andyshinn/yamb/components/PJ_044A/PJ-044A.step

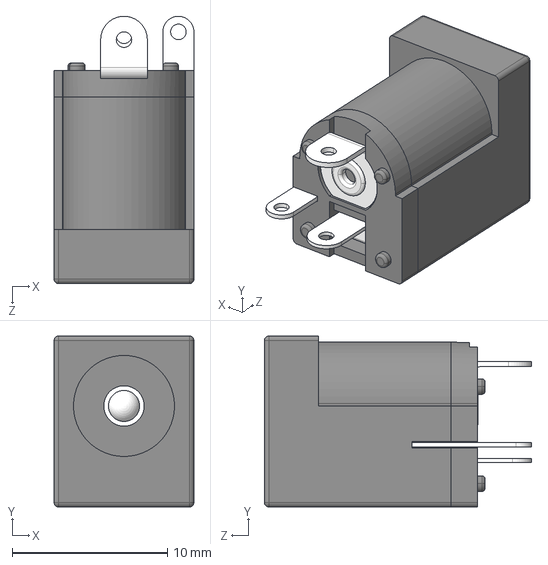
[picture p2: CAD file, 2025-06-29]
components/PJ_044A/PJ-044A.step
9.00 x 11.0 x 17.2 mm
