andyshinn/yamb/components/UJ20-C-V-C-3-SMT-TR.STEP

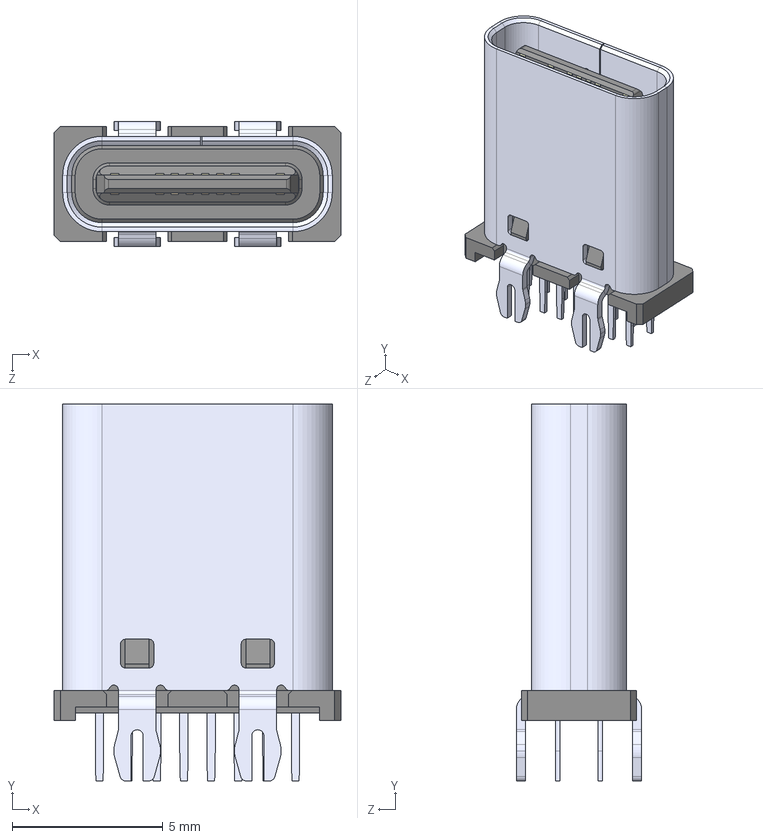
[picture p3: CAD file, 2025-07-02]
components/UJ20-C-V-C-3-SMT-TR.STEP
9.50 x 12.5 x 4.16 mm
