andyshinn/yamb/drawings/PCB - Outline.dxf

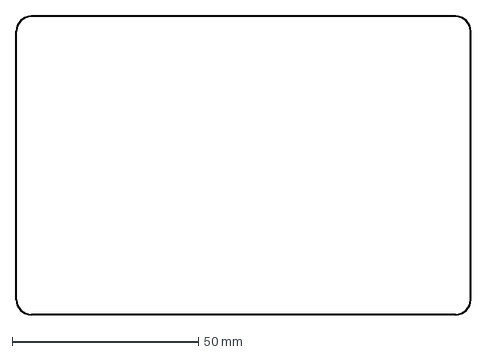
[picture p4: CAD file, 2025-06-27]
drawings/PCB - Outline.dxf
122.0 x 80.0 mm
