andyshinn/yamb/components/RAK4630.step

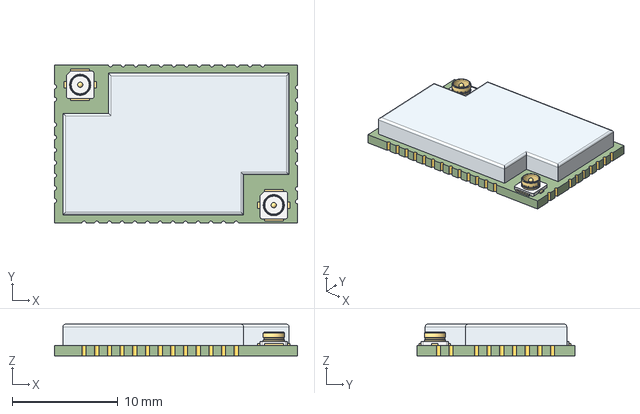
[picture p5: CAD file, 2025-06-29]
components/RAK4630.step
23.0 x 15.0 x 3.00 mm
734120110wbm000_01 x 2
PCB
