andyshinn/yamb/components/SVR.step

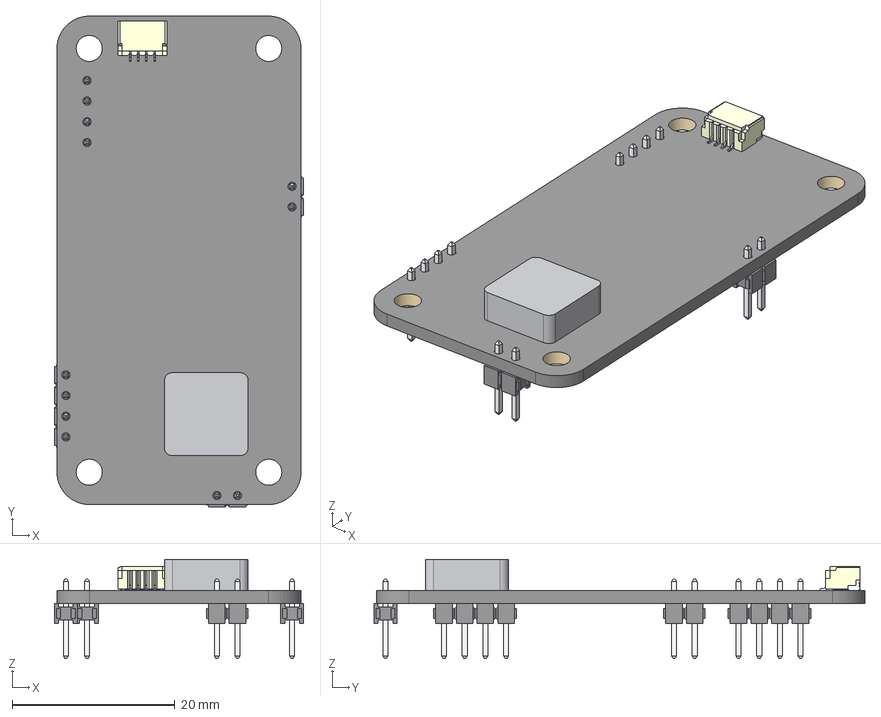
[picture p6: CAD file, 2025-06-29]
components/SVR.step
30.6 x 60.3 x 12.2 mm
xg8s-0231 x 2
xg8s-0431 x 2
PCB
Inductor
SM04B-SRSS-TB(LF)(SN) x 7
