andyshinn/yamb/components/MCSBC.step

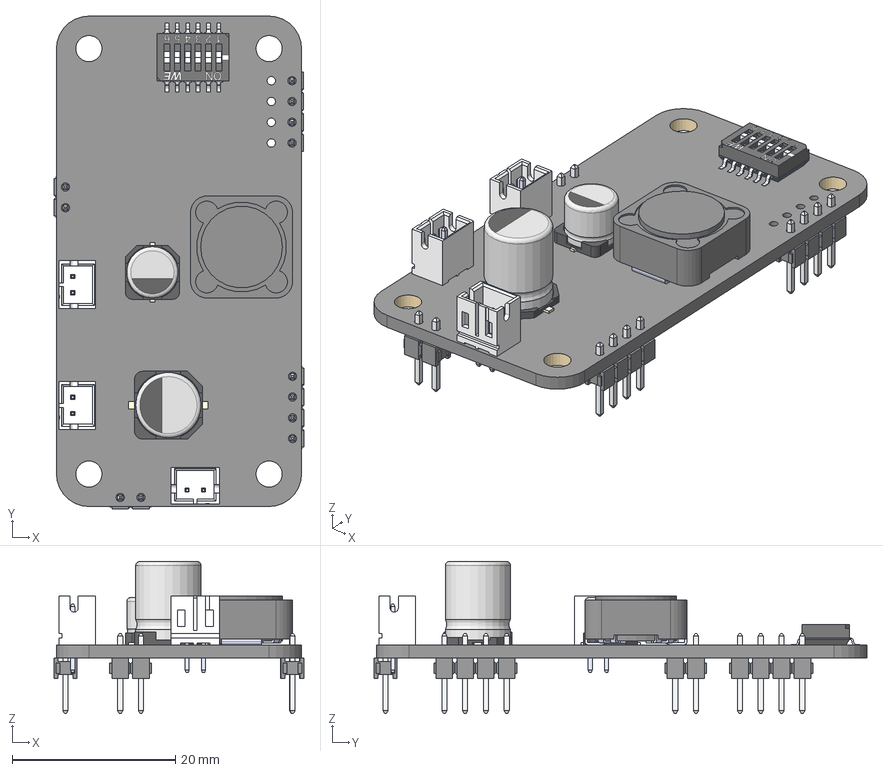
[picture p7: CAD file, 2025-06-29]
components/MCSBC.step
30.6 x 60.3 x 18.6 mm
xg8s-0231 x 2
xg8s-0431 x 2
??SIZE CODE F-002
??SIZE CODE F-001
??SIZE CODE F-003_1
??SIZE CODE F-003
??SIZE CODE D-002
??SIZE CODE D-001
??SIZE CODE D-003_1
??SIZE CODE D-003
PCB
DR125-220-R x 3
B2B-PH-K-xxxx x 9
Actuator
Terminal_5 x 2
Actuator_4
Actuator_2
Actuator_5
Actuator_1
Terminal_4 x 2
Contact
Actuator_3
Contact_1
Terminal_3 x 2
Contact_2
Contact_3
Terminal_2 x 2
Contact_4
Terminal_1 x 2
Contact_5
Lead_Terminal 06
Terminal x 2
Housing_06
