andyshinn/yamb/components/PC722A.step

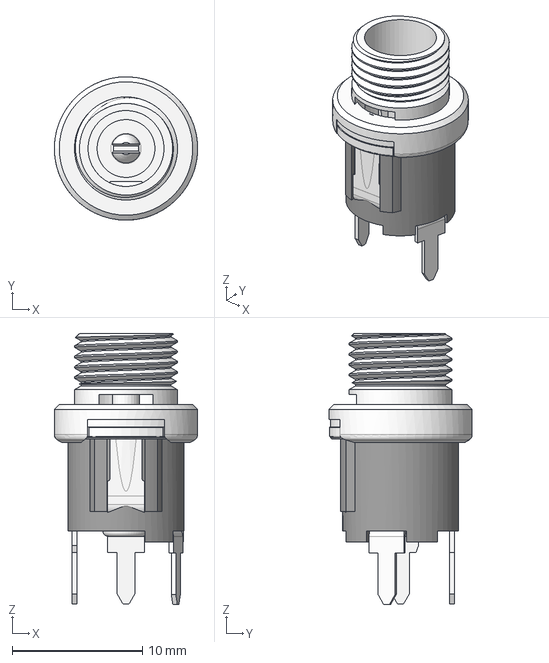
[picture p8: CAD file, 2025-06-29]
components/PC722A.step
11.0 x 11.0 x 20.8 mm
