andyshinn/yamb/yamb.kicad_pcb

## KiCad design yamb.kicad_pcb (2025-08-15)

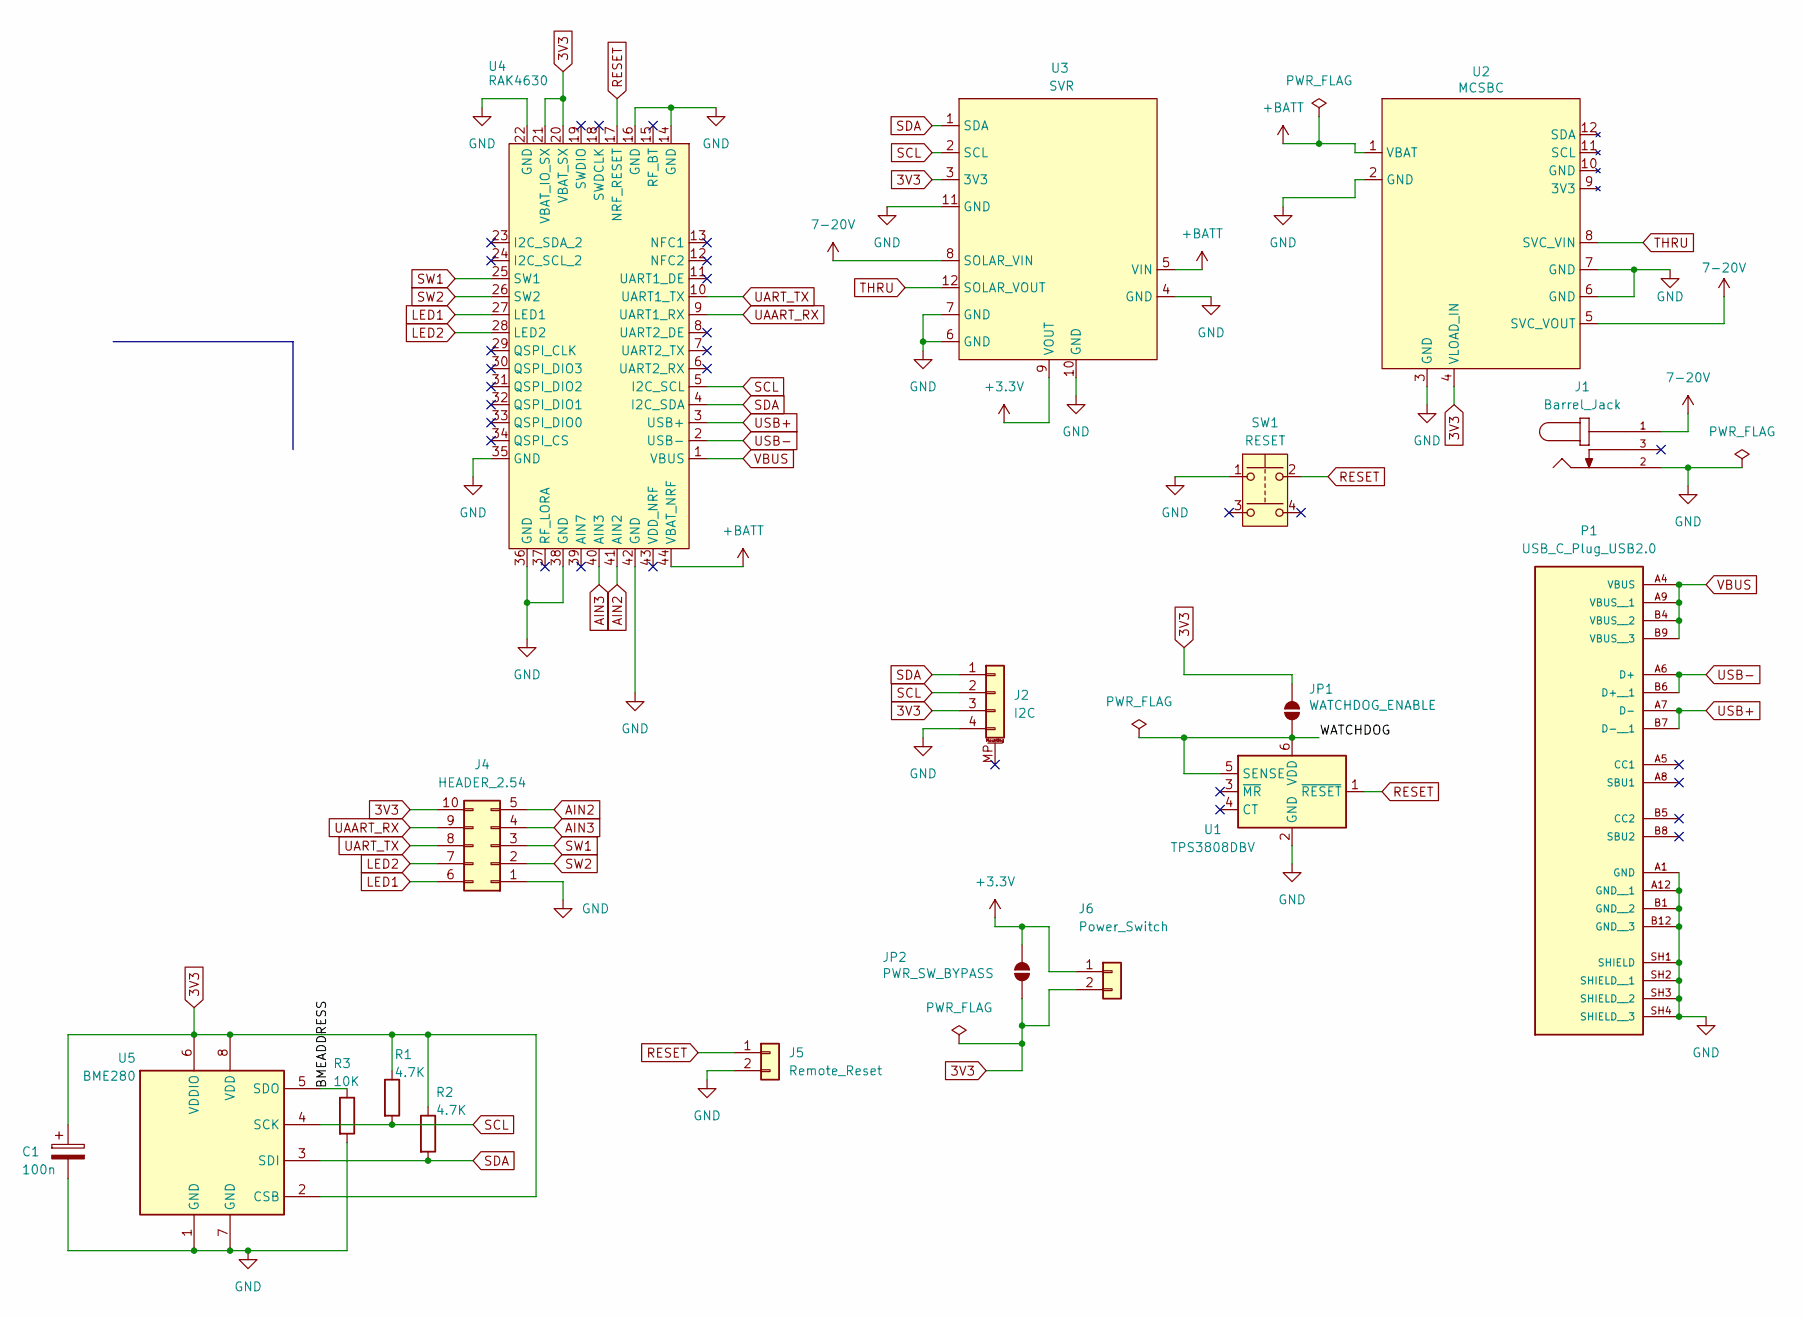
[picture p9: schematic yamb.kicad_sch]

Parts:
C1: 100n; C_1206_3216Metric_Pad1.33x1.80mm_HandSolder
J1: Barrel_Jack; CUI_PJ-044A; PARTREV 1.02
J2: I2C; JST_SH_BM04B-SRSS-TB_1x04-1MP_P1.00mm_Vertical
J4: HEADER_2.54; CONN_7024610xx_MOL
J5: Remote_Reset; CONN_SDA-70543-xxxx_02_MOL
J6: Power_Switch; CONN_SDA-70543-xxxx_02_MOL
JP1: WATCHDOG_ENABLE; SolderJumper-2_P1.3mm_Open_RoundedPad1.0x1.5mm
JP2: PWR_SW_BYPASS; SolderJumper-2_P1.3mm_Open_RoundedPad1.0x1.5mm
P1: USB_C_Plug_USB2.0; SAMESKY_UJ20-C-V-G-SMT-P16-TR; PARTREV 1.0
R1, R2: 4.7K; R_1206_3216Metric_Pad1.30x1.75mm_HandSolder
R3: 10K; R_1206_3216Metric_Pad1.30x1.75mm_HandSolder
SW1: RESET; SW_1825910-6-4
U1: TPS3808DBV; SOT-23-6
U2: MCSBC; Voltaic_MCSBC
U3: SVR; Voltaic_SVR
U4: RAK4630
U5: BME280; Bosch_LGA-8_2.5x2.5mm_P0.65mm_ClockwisePinNumbering

Connections:
3V3: C1.1, J2.3, J4.10, J6.2, JP1.1 (A), JP2.2 (B), R1.1, R2.1, U2.4 (VLOAD_IN), U3.3 (3V3), U4.20 (VBAT_SX), U4.21 (VBAT_IO_SX), U5.2 (CSB), U5.6 (VDDIO), U5.8 (VDD)
7-20V: J1.1, U2.5 (SVC_VOUT), U3.8 (SOLAR_VIN)
+3.3V: J6.1, JP2.1 (A), U3.9 (VOUT)
+BATT: U2.1 (VBAT), U3.5 (VIN), U4.44 (VBAT_NRF)
/BMEADDRESS: R3.1, U5.5 (SDO)
/WATCHDOG: JP1.2 (B), U1.5 (SENSE), U1.6 (VDD)
AIN2: J4.5, U4.41 (AIN2)
AIN3: J4.4, U4.40 (AIN3)
GND: C1.2, J1.2, J2.4, J4.1, J5.2, P1.A1 (GND), P1.A12 (GND__1), P1.B1 (GND__2), P1.B12 (GND__3), P1.SH1 (SHIELD), P1.SH2 (SHIELD__1), P1.SH3 (SHIELD__2), P1.SH4 (SHIELD__3), R3.2, SW1.1, U1.2 (GND), U2.2 (GND), U2.3 (GND), U2.6 (GND), U2.7 (GND), U3.4 (GND), U3.6 (GND), U3.7 (GND), U3.10 (GND), U3.11 (GND), U4.14 (GND), U4.16 (GND), U4.22 (GND), U4.35 (GND), U4.36 (GND), U4.38 (GND), U4.42 (GND), U5.1 (GND), U5.7 (GND)
LED1: J4.6, U4.27 (LED1)
LED2: J4.7, U4.28 (LED2)
RESET: J5.1, SW1.2, U1.1 (~RESET), U4.17 (NRF_RESET)
SCL: J2.2, R1.2, U3.2 (SCL), U4.5 (I2C_SCL), U5.4 (SCK)
SDA: J2.1, R2.2, U3.1 (SDA), U4.4 (I2C_SDA), U5.3 (SDI)
SW1: J4.3, U4.25 (SW1)
SW2: J4.2, U4.26 (SW2)
THRU: U2.8 (SVC_VIN), U3.12 (SOLAR_VOUT)
UAART_RX: J4.9, U4.9 (UART1_RX)
UART_TX: J4.8, U4.10 (UART1_TX)
USB+: P1.A7 (D-), P1.B7 (D-__1), U4.3 (USB+)
USB-: P1.A6 (D+), P1.B6 (D+__1), U4.2 (USB-)
VBUS: P1.A4 (VBUS), P1.A9 (VBUS__1), P1.B4 (VBUS__2), P1.B9 (VBUS__3), U4.1 (VBUS)

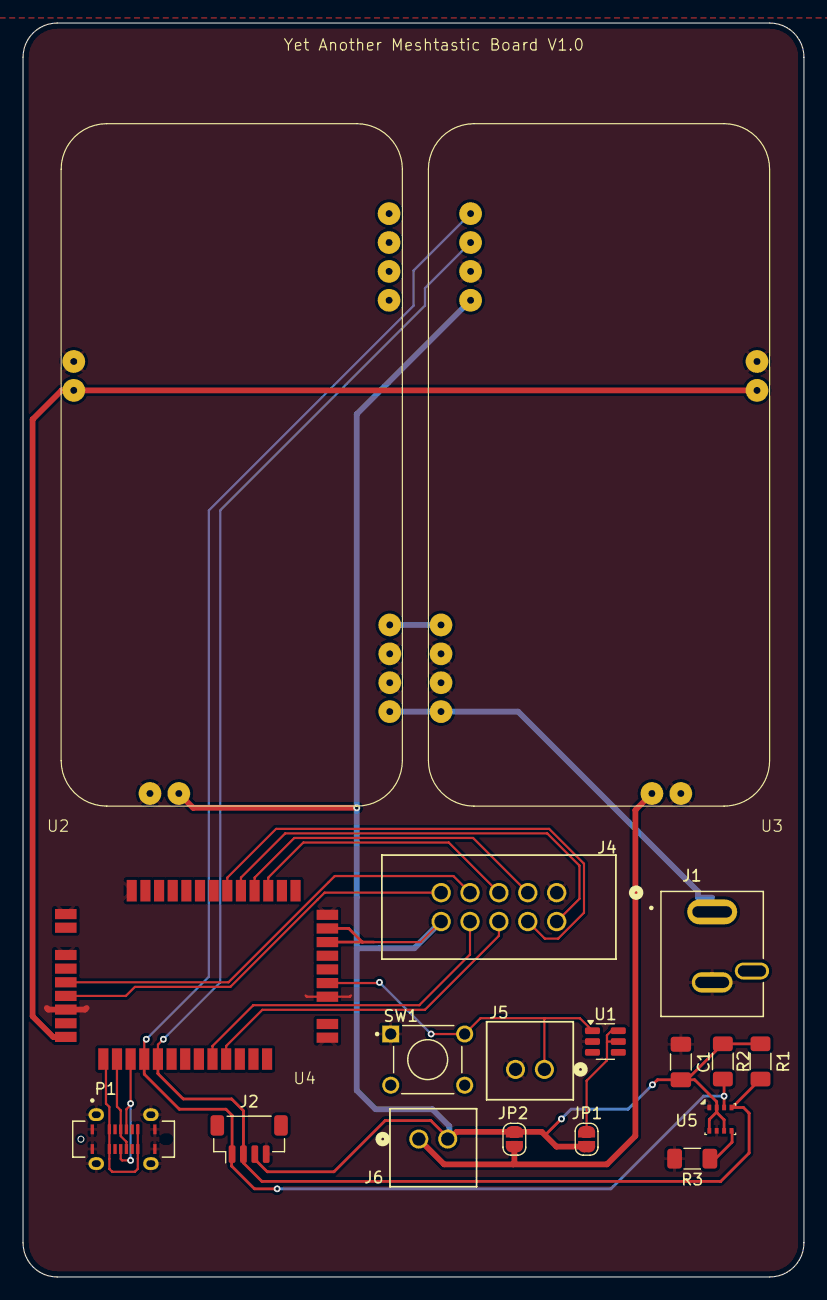
[picture p10: board yamb.kicad_pcb from above]

Board: 2 copper layers, 68.7 x 110.2 mm, 18 parts (0 on the bottom side), 22 nets.
