andyshinn/yamb/(commit log)

2025-06-05 yet another meshtastic board!
    [yamb.kicad_pcb, yamb.kicad_sch]
2025-06-06 still lots of errors
    [yamb.kicad_sch]
2025-06-23 voltaic footprints, adding to schematic
    [yamb.kicad_pcb, yamb.kicad_sch]
2025-06-24 additional footprints for reset, power switch, correct USB-C symbol for footprint, bypass jumpers for watchdog and pwr switch
    [yamb.kicad_pcb, yamb.kicad_sch]
2025-06-26 custom libraries
    [yamb.kicad_pcb, yamb.kicad_sch]
2025-06-27 solving ERC errors
    [yamb.kicad_pcb, yamb.kicad_sch]
2025-06-27 PCB layout first pass
    [yamb.kicad_pcb, yamb.kicad_sch]
2025-06-27 some board layout stuff
    [PCB - Outline.dxf, yamb.kicad_pcb, yamb.kicad_sch]
2025-06-29 some 3D components, adding BME280, some 3V3 vs 3.3V fixes
    [MCSBC.step, PC722A.step, PJ-044A.step, RAK4630.step, SVR.step, yamb.kicad_pcb, yamb.kicad_sch]
2025-06-29 see if kicanvas works without embedded file
    [yamb.kicad_pcb]
2025-06-29 remove embedded rake4630 layout as well
    [yamb.kicad_pcb]
2025-06-29 schematic instead of model since that doesn't work in readme
2025-07-02 changed connectors to shroued 0.1" and cleaned some board DRC errors
    [UJ20-C-V-C-3-SMT-TR.STEP, UJ20-C-V-C-3-SMT-TR.step, yamb.kicad_pcb, yamb.kicad_sch]
